17681020648-debug/wudi/docs/TO247-3_Bent90_Right_WhiteUp_README.md

# TO-247-3 90° bent STEP model

- **File:** `TO247-3_Bent90_Right_WhiteUp.step`
- **Units:** mm
- **Orientation:** PCB reference plane `Z=0`; package body extends toward `+X` (right); white/silver metal mounting tab is the `+Z` (up) face.
- **Leads:** three rectangular leads at `Y=-5.45, 0, +5.45`; each bends 90° with a 1.5 mm centerline radius and extends to `Z=-3 mm` for PCB insertion.
- **Envelope used:** molded body X=6…26.9, Y=±7.95, Z=4…8.8; metal tab X=7.4…25.9, Y=±7.95, Z=8.8…9.6; mounting hole Ø3.6 mm at X=20.8, Y=0.
- **Scope:** generic TO-247-3 mechanical reference based on the supplied images. Verify the selected device’s package drawing, pin pitch, lead thickness, tab size and hole position before releasing PCB or tooling data.

The model is a reference geometry; it is not a manufacturer-certified package model.
