17681020648-debug/wudi/docs/TO247-3_Bent90_Right_WhiteUp.step

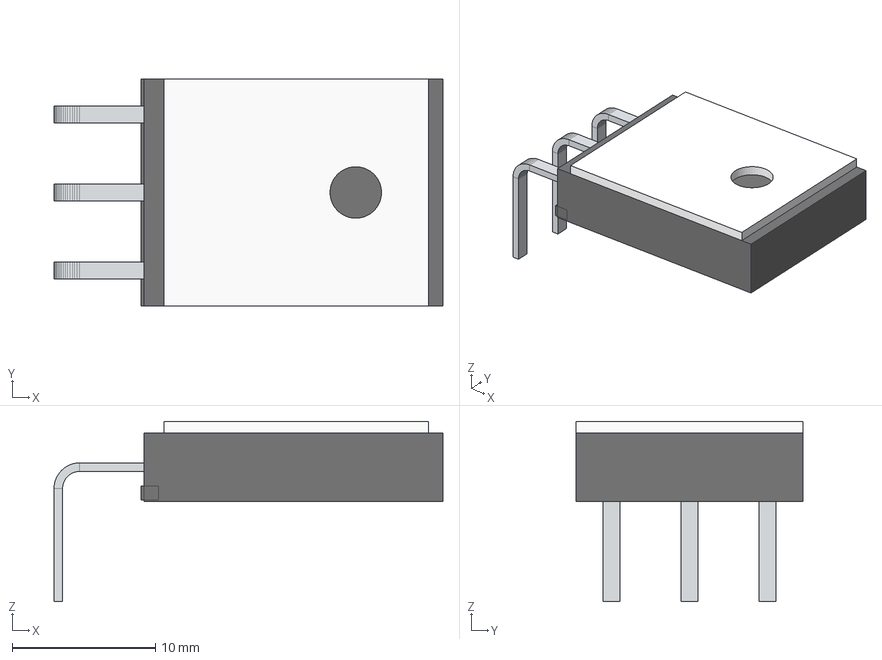
[picture p3: CAD file, 2026-10-14]
docs/TO247-3_Bent90_Right_WhiteUp.step
27.2 x 15.9 x 12.6 mm
Molded_body_black
Metal_tab_white_up
Lead_1_bent_90deg
Lead_2_bent_90deg
Lead_3_bent_90deg
