17681020648-debug/wudi/(commit log)

2026-10-12 Add PQ3235 transformer sample specification
2026-10-12 Revise transformer specification for wire winding and window review
2026-10-14 Add bent TO-247 3D reference model
    [TO247-3_Bent90_Right_WhiteUp.step]
